lohitashva2004-netizen/context-aware-predictive-maintenance/context-aware-predictive-maintenance/firmware/esp32_edge_node/config.example.h

// Copy this file to config.h and fill in your own values.
// config.h is git-ignored so credentials are never committed.
#pragma once

#define WIFI_SSID        "your-wifi-ssid"
#define WIFI_PASSWORD    "your-wifi-password"

#define MQTT_HOST        "xxxxxxxxxxxxxxxx.s1.eu.hivemq.cloud"
#define MQTT_PORT        8883
#define MQTT_USER        "your-hivemq-username"
#define MQTT_PASSWORD    "your-hivemq-password"
#define MQTT_TOPIC       "motor/all"
